marcos-rb/rspidr/README.md

# rspidr
Arquivos do projeto do respirador rspidr
