marcos-rb/rspidr/programacao_arduino/readme.txt

Programação em Arduino utilizada pelo projeto rspidr.

A programação ainda está em andamento, disponível para a conferência apenas.
Não é recomendado a utilização da programação em que se encontra.
Ela necessita da biblioteca "LiquidCrystal.h" para seu correto funcionamento, sendo padrão do Arduino e não adicionada nesta pasta. 

O arquivo rspidr_arduino.ino é o principal.
