marcos-rb/rspidr/stl_files/V3-X3-MRB+topsup.STL

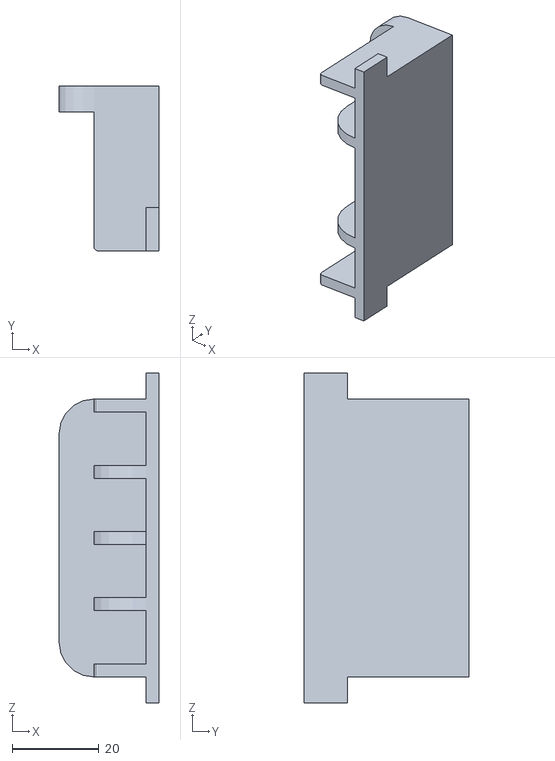
[picture p9: CAD file, 2020-08-14]
stl_files/V3-X3-MRB+topsup.STL
23.0 x 38.0 x 76.0
