marcos-rb/rspidr/stl_files/V3-7-MRB.STL

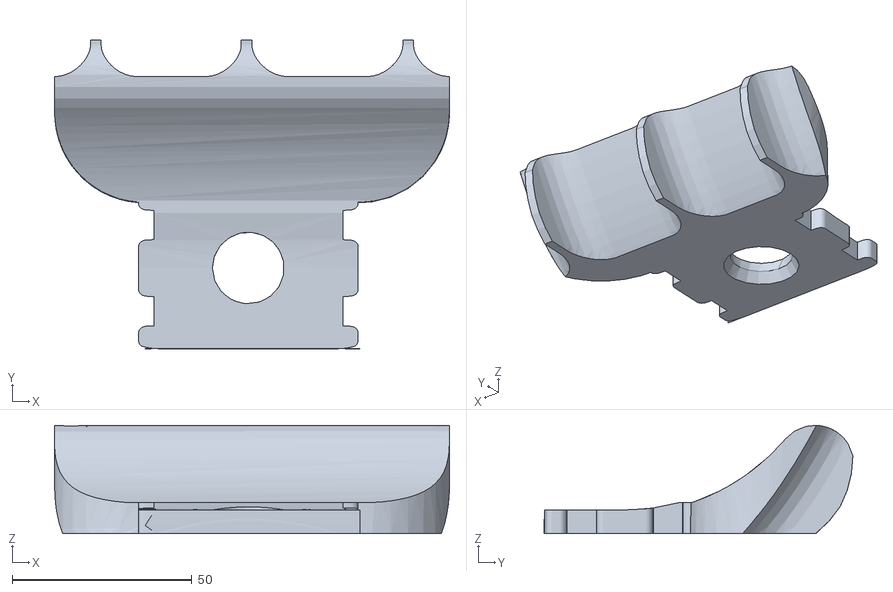
[picture p10: CAD file, 2020-08-14]
stl_files/V3-7-MRB.STL
110.0 x 86.0 x 30.2
