marcos-rb/rspidr/stl_files/V3-X2-MRB+bottomsup.STL

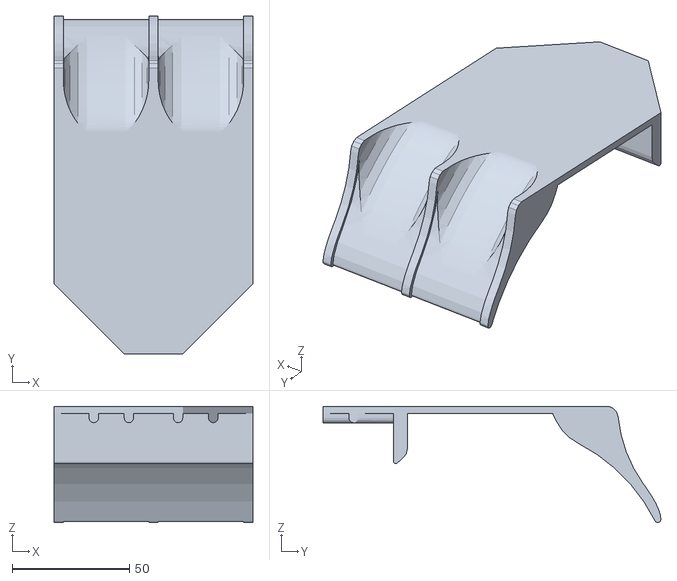
[picture p11: CAD file, 2020-08-14]
stl_files/V3-X2-MRB+bottomsup.STL
85.0 x 144.3 x 49.6
