marcos-rb/rspidr/stl_files/V3-10-MRB.STL

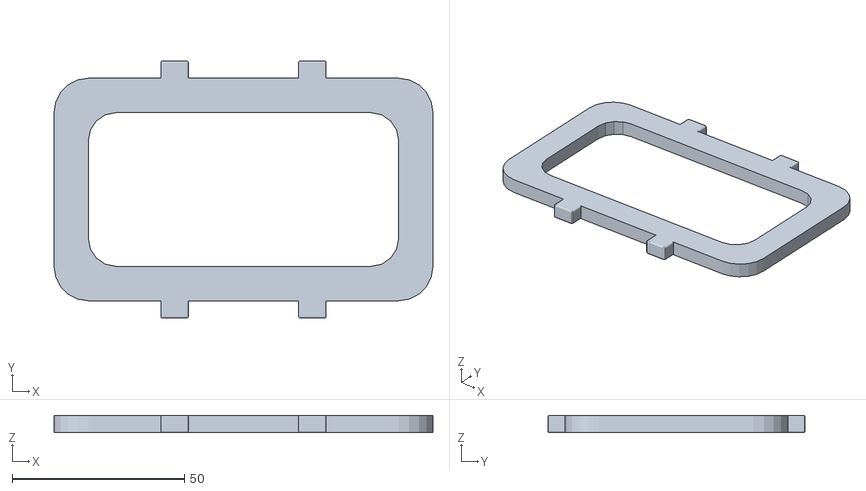
[picture p12: CAD file, 2020-08-14]
stl_files/V3-10-MRB.STL
110.0 x 74.6 x 5.00
