marcos-rb/rspidr/stl_files/V3-1.STL

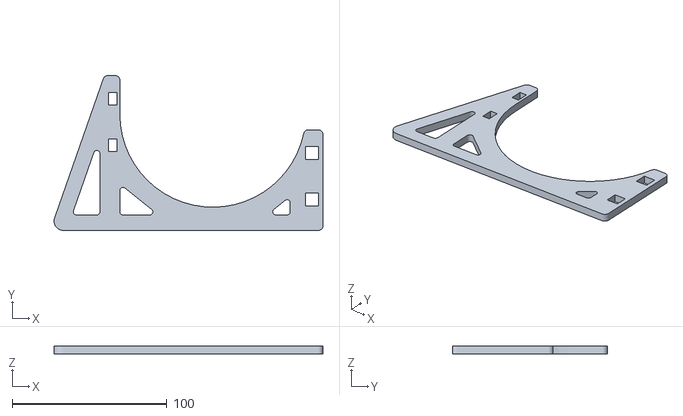
[picture p13: CAD file, 2020-06-26]
stl_files/V3-1.STL
173.7 x 100.0 x 5.00
