marcos-rb/rspidr/stl_files/V3-9.STL

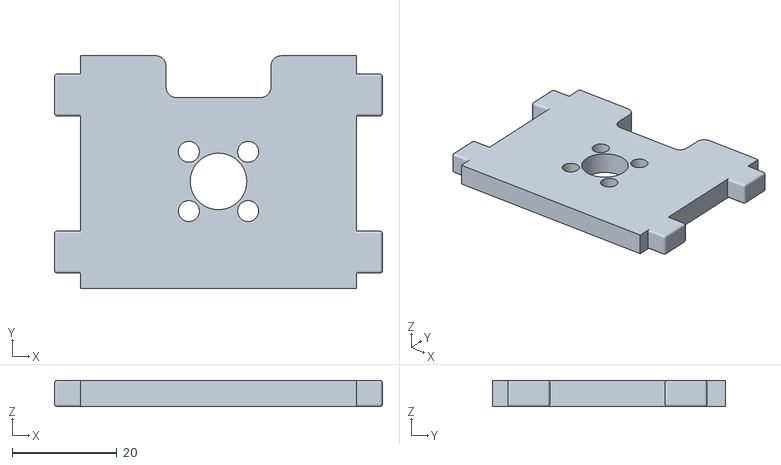
[picture p14: CAD file, 2020-06-26]
stl_files/V3-9.STL
62.6 x 44.4 x 5.00
