marcos-rb/rspidr/stl_files/V3-4.STL

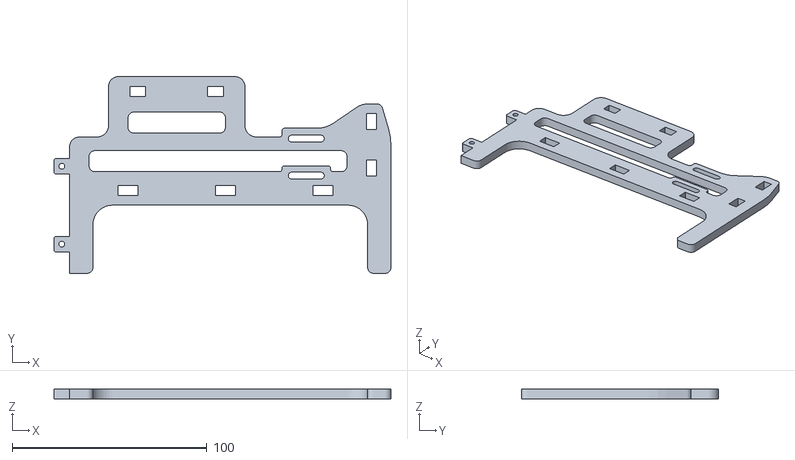
[picture p15: CAD file, 2020-06-26]
stl_files/V3-4.STL
173.0 x 101.0 x 5.00
