marcos-rb/rspidr/stl_files/V3-X1-MRB+endstopsup.STL

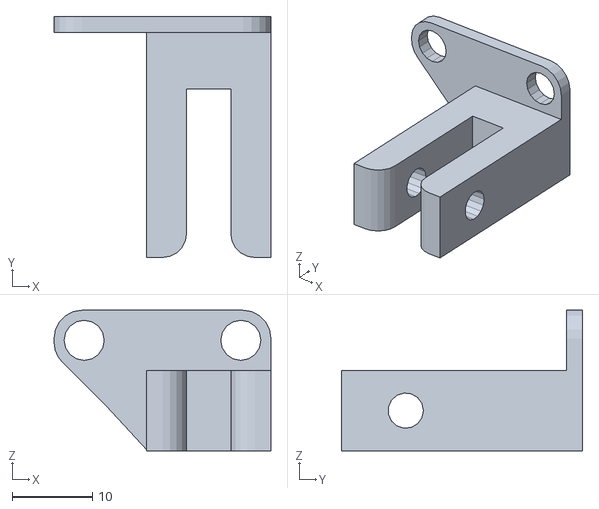
[picture p16: CAD file, 2020-06-26]
stl_files/V3-X1-MRB+endstopsup.STL
27.0 x 30.0 x 17.5
