marcos-rb/rspidr/stl_files/V3-5.STL

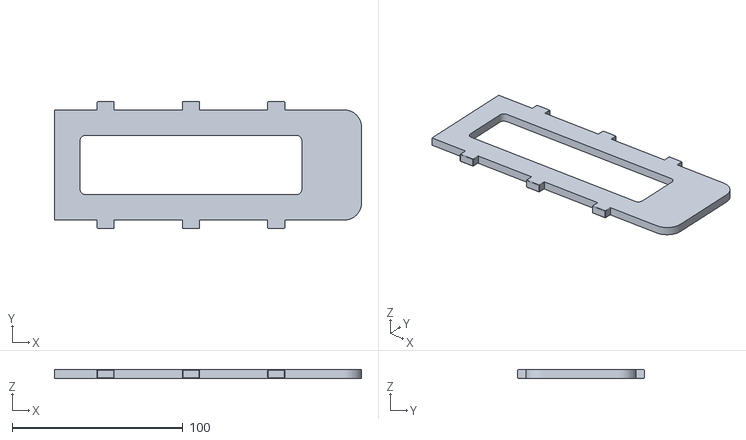
[picture p17: CAD file, 2020-06-26]
stl_files/V3-5.STL
180.0 x 74.6 x 5.00
