marcos-rb/rspidr/stl_files/V3-6.STL

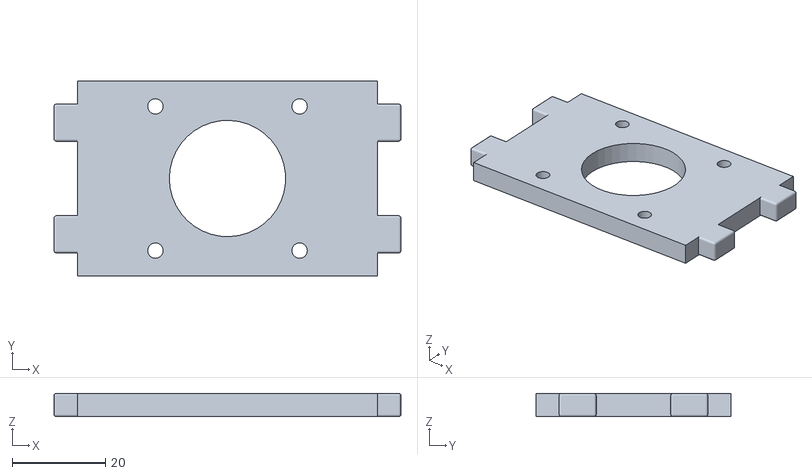
[picture p18: CAD file, 2020-06-26]
stl_files/V3-6.STL
74.6 x 42.0 x 5.00
