marcos-rb/rspidr/stl_files/V3-2.STL

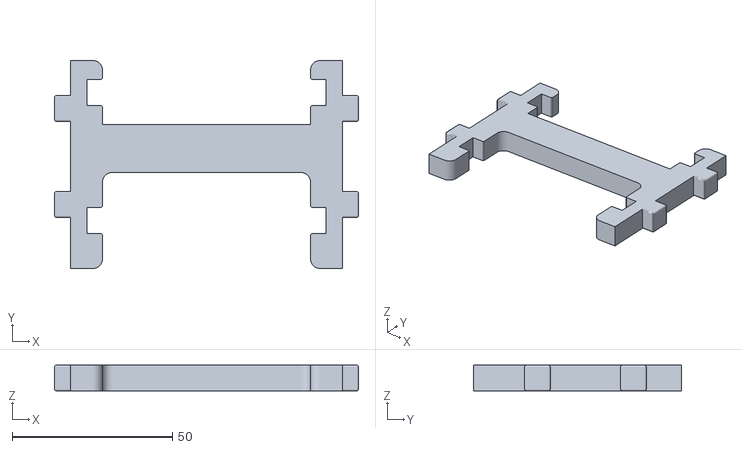
[picture p19: CAD file, 2020-06-26]
stl_files/V3-2.STL
95.0 x 65.0 x 8.00
