marcos-rb/rspidr/stl_files/V3-8.STL

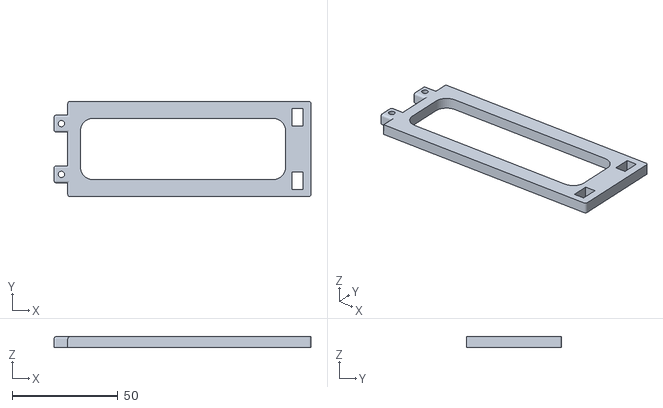
[picture p20: CAD file, 2020-06-26]
stl_files/V3-8.STL
121.5 x 45.0 x 5.00
