marcos-rb/rspidr/stl_files/V3-3.STL

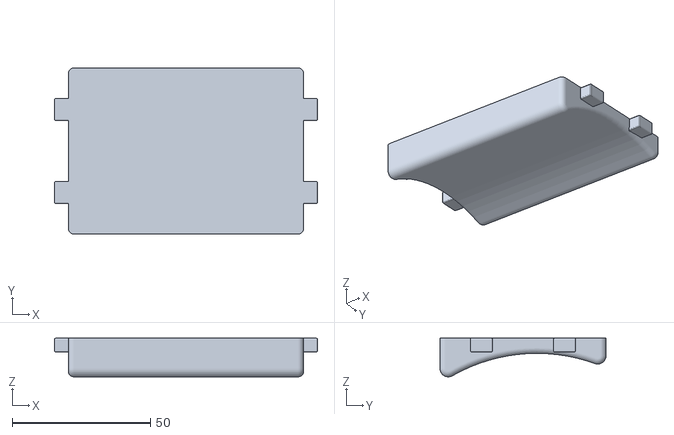
[picture p21: CAD file, 2020-06-26]
stl_files/V3-3.STL
95.0 x 60.0 x 14.0
