marcos-rb/rspidr/(commit log)

2020-06-27 Move to folder stl_files
    [V3-1.STL, V3-10.STL, V3-11_MRB+pulley150.STL, V3-12_MRB+pulley36.STL, V3-13_MRB+disk.STL, V3-2.STL, V3-3.STL, V3-4.STL]
2020-06-27 Programação Arduino
    Versão beta (Rspidr_MRB_v0.2)
2020-08-14 Arquivos mecânicos atualizados
    Atualização dos arquivos mecânicos, até o momento estava no arquivo o sistema de polias, que não é mais utilizado no sistema atual.
    Criado as peças mrb+bottomsup e mrb+topsup , para a inserção do parafuso.
    [V3-10-MRB.STL, V3-10.STL, V3-11_MRB+pulley150.STL, V3-12_MRB+pulley36.STL, V3-13_MRB+disk.STL, V3-6_MRB+substitute.STL, V3-7-MRB.STL, V3-7.STL]
2020-08-14 Atualizado nomes dos arquivos
    Nenhuma alteração, apenas a correção dos nomes e adição de um readme
